elhep/SPEC_A7_Management/README.md

# SPEC_A7_Management
A plugin board for WR node management with ARM processor, SFP and RJ45
