elhep/SPEC_A7_Management/SPEC_A7_Management.html

Reporting Options

# File in Newer Format

Date | : | 27.06.2024
Time | : | 14:12:44
Project name | : | C:\Users\candle\Documents\polibuda\SPEC_A7_Management\SPEC_A7_Management.PrjPcb
Schematic documents | : | ETH_PHY_SFP.SchDoc , SPEC_A7_Power.SchDoc , SPEC_A7_SoM.SchDoc

Version | Warning
21.9.0 | Internal Pull Up/Down resistor in components are not supported in this version.
22.3.0 | Custom diff pair suffixes are not supported in this version.

These files were generated in a later version of Altium Designer. Be aware that some data may have been added through functionality not available in your current version and will therefore not be available to you.
