elhep/SPEC_A7_Management/SPEC_A7_Management.PCBDOC.htm

Reporting Options

# File in Newer Format

Date | : | 27.06.2024
Time | : | 14:24:59
Filename | : | C:\Users\candle\Documents\polibuda\SPEC_A7_Management\SPEC_A7_Management.PCBDOC

Version | Warning
Release 23.6 | CAUTION - The PCB document contains Footprint parameters. These will be lost when opening the document in a version of Altium Designer that does not support this functionality.

This file was generated by a later version of the software
