elhep/SPEC_A7_Management/SPEC_A7_Management.step

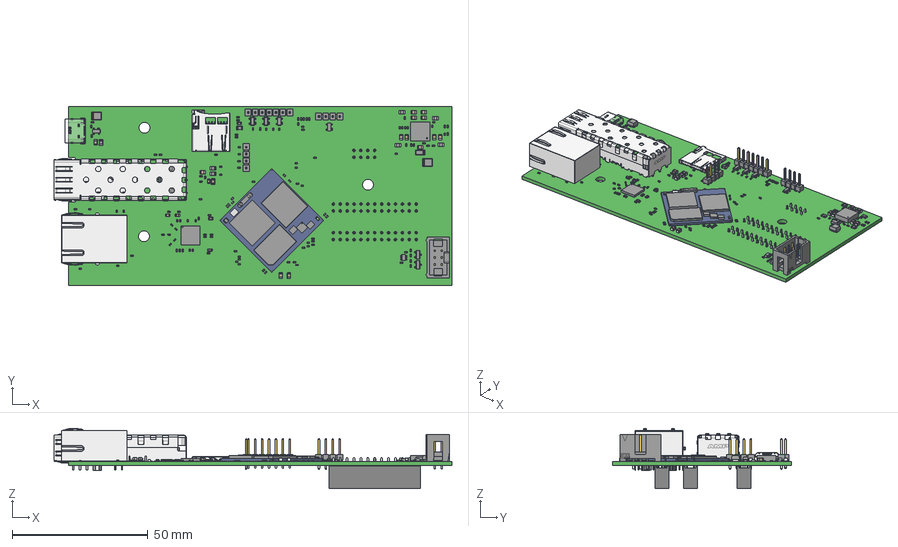
[picture p1: CAD file, 2024-09-16]
SPEC_A7_Management.step
146.4 x 65.8 x 22.2 mm
RESC1005X40N x 79
SOT65P210X110-6N
SOT95P248X115-3N x 2
INDC2012X110N x 4
ATTEND_112A-TAAR-R03
CAPC1005X55N x 39
CAPC1608X80N x 6
6130xx21821_PIN x 60
3M_N2506-6002RB
SOT143N x 5
SAMTEC_TSW-104-23-L-S x 2
RESC2012X60N x 4
SAMTEC_TSW-107-07-L-S-LL
USB4105-15-A_PART2
1_MIR
GCT
TYCO_1367073-1
BEL_L829-1J1T-43
MPS_MPM54304GMN
CAPC2012X135N x 14
CAPMP3528X210N x 2
KARO_QSMP-1530
QFN50P700X700X100-49N-S420
TYCO_6367035-1_(Cage Top)
TYCO_6367034-1_(Cage Bot)
