elhep/SPEC_A7_Management/(list of files, drawings)

Other design files:
ETH_PHY_SFP.SchDoc
SPEC_A7.SchDoc
SPEC_A7_Management.PCBDOC
SPEC_A7_Management.PcbLib
SPEC_A7_Management.PrjPcb
SPEC_A7_Management.SCHLIB
SPEC_A7_Managment-TOP.SchDoc
SPEC_A7_Power.SchDoc
SPEC_A7_SoM.SchDoc
