elhep/SPEC_A7_Management/(threads)

Thread 1 (2024-05-31):

Management board for SPEC-A7

gkasprow, 2024-05-31:
The management board has the following features:
- RJ45 Base10/100/1000 T Ethernet connector (DP83869HMRGZ); use low cost connector
- SFP 100/1000 Ethernet connector (same DP83869HMRGZ as above)
- automatic detection between SFP/RJ45, using SFP present signal (needs PHY reconfiguration)
- ARM SOM capable of running Linux and 2x RGMII Ethernet (QSMP); one RGMII goes to PHY, another goes to SPEC-A7; don't forget about series termination
- must fit together with SPEC-A7 into F1040-160 Bopla enclosure
- 4 layer PCB

Example configuration:
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

gkasprow, 2024-06-07:
The CPU is connected in following way:
- RGMII 1 routed to PHY which is shared between RJ45 and SFP
- RGMII 2 routed to WR node connector
- UART is routed to WR node connector
- CPU supply is derived from 12V rail on WR node connector

Thread 2 (2024-06-28):

design review

gkasprow, 2024-06-28:
SCH:
- [ ] add .gitignore
- [ ] add IDC connector with power supply status
- [ ] that thing won't work: the MCP has open drain, connect button to its output, VDD to 3V3 and passive network is not needed
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
- [ ] the power supply chip already generates PG signal that can be used to reset the SOM as in the original design
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
- [ ] such thing is hard to read, just route individual GPIOs without harnesses
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
- [ ] for the moment P1V1 wakes up first with 1V8, then 2V5 and 3V3. It violates the PHY sequence requirements
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

- [ ] connect SFP I2C to SoM. We need to report the optical power and configure SFP between SGMII/1000base-x mode
- [ ] use WUT schematic[ template](https://www.dropbox.com/scl/fi/se83k2msd5s09xg1agza3/WUT-template-A3.SchDot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) everywhere:
- [ ] add 33Ohm series termination resistors at the RGMII output lines that go to the FPGA
- [ ] add series 1k resistors between FPGA and SoM to prevent from latchup
- [ ] add 1A thermal fuse on USB port; during plug insertion the buck may restart and may cause to restart other channels.
- [ ] there are no strapping pins (PHY config) on schematic; is this done on purpose?
- [ ] pls add voltage detection circuit that will report loss of one of redundant supplies
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

- [ ] place the power unit status header somewhere here
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

gkasprow, 2024-06-28:
PCB:

- [ ] follow datasheet of SOM with vias tenting; copy the footprint from K700-178 design
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
- [ ] replace SOM and other libs with CERN symbols and footprints

gkasprow, 2024-06-28:
- [ ] use one of [supported OpenOCD jtag](https://openocd.org/pages/supported-jtag-interfaces.html) adapters, for the moment Xilinx JTAG connector is used; maybe switch to the pin header used on Ka-Ro boards
- [ ]
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

gkasprow, 2024-07-09:
there is conflict with enclosure
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
The 2.54 connectors are too high, the RJ45 will hit the wall
Use lower profile connectors, for the moment elevated ones are used with no reason

Thread 3 (2024-06-28):

for the moment P1V1 wakes up first with 1V8, then 2V5 and 3V3. It violates the PHY sequence requirements

gyorka, 2024-06-28:

gyorka, 2024-06-28:
actually, what the table says is that any of the supply voltages needs to ramp up in minimum of 0.5ms, but also that there is no sequence to be followed - any voltage can start within the period of 0 to 100ms and device will function as designed

Closed 2024-06-28.

Thread 4 (2024-07-02):

we need R20 and R22 to talk to SFP

gyorka, 2024-07-02:

gyorka, 2024-07-02:
without Ka-Ro QS93 SoM schematics it's uncertain if pull-up resistors are present on SDA/SCL lines or not, thus R20 and R22 are TBD, and currently marked as not populated

gkasprow, 2024-07-03:
the schematics are on my dropbox

Thread 5 (2024-07-02):

there are no strapping pins (PHY config) on schematic; is this done on purpose?

gyorka, 2024-07-02:

gyorka, 2024-07-02:
DP83869 default configuration, without any bootstraping resistors added is 1000Base-T using RGMII interface as required by the project
futher configuration can be adjusted with MDIO interface

Closed 2024-07-02.

Thread 6 (2024-07-02):

add 33Ohm series termination resistors at the RGMII output lines that go to the FPGA

gyorka, 2024-07-02:

gyorka, 2024-07-02:
at spec_a7 fpga_34.schdoc there are 33R resistors at RGMII TX lines, should we add 33R resistors at RX lines here? or its already good as it is?
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

gkasprow, 2024-07-03:
Oh, the resistor on SPEC side are on wrong lines, FPGA Tx means input; Add them on Tx lines on your side

gyorka, 2024-07-03:
so I should also connect TX to RX port and vice versa?

gkasprow, 2024-07-03:
No, follow Ethernet rules; Rx connects with Rx, Tx with Tx;
use source ermination on your output signals

gyorka, 2024-07-08:
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
done

Closed 2024-07-08.

Thread 7 (2024-07-02):

pls add voltage detection circuit that will report loss of one of redundant supplies ; do NOT connect P5V0 rail to this connector!

gyorka, 2024-07-02:

gyorka, 2024-07-02:
we have no redundant power supply - all we have is a single 12V source plus a single 3.3V source

what good would detection of 12V supply loss would do if our lights went off?

gkasprow, 2024-07-03:
We do have redundant power supply
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

gyorka, 2024-07-07:
as already stated: we don't have any redundant power supply within spec_a7_managment board - all we have is single 12V supply and single 3.3V supply

gkasprow, 2024-07-07:
Just implement it. We do have redundant power board with 2 IEC power entries.

gkasprow, 2024-07-07:
Its outside of this board but management board will send notification about loss of one of supplies using snmp.

Closed 2024-07-09.

Thread 8 (2024-07-04):

add SPI upgrade connector

gkasprow, 2024-07-04:
add yet another connector for FPGA SPI upgrade
connect FPGA DONE, INIT and UP EN to GPIOs

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

gyorka, 2024-07-08:
we need SAMTEC_ESQ-104-12-L-D for this, using "compatible" connector right now, CERN library needs to be updated

Closed 2024-07-08.

Thread 10 (2024-07-08):

USB port lacks 5V power; SOM does not generate 5V power! re-arrange the power supply chip and let the PHY generate one of the voltages internally

gyorka, 2024-07-08:

gyorka, 2024-07-08:
USB as is is configured for DEVICE mode of operation (5k1 resistors on CC pins), and 5V should be provided from the host
On SoM there is voltage divider on that pin to detect it.
USB port in this form is inteded to be used as SoM firmware update port, nothing else
for more convinient firmware development, SD card connector is provided, and we can use ethernet and scp for smaller files

gkasprow, 2024-07-09:
This is USB Host. Please add jumper that let the user to switch roles.
We need USB host to talk to FTDI on lower board to debug FPGA design remotely.

Closed 2024-07-08.

Thread 15 (2025-04-07):

missing I2C routing for SFP

ras14k, 2025-04-07:
signals on the schematic are connected in wrong order (SCL/SDA swapped):
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

missing routing:
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

Thread 18 (2025-04-07):

missing pull-up resistor on PWR_GOOD signal

ras14k, 2025-04-07:
without pull-up resistor SoM is permanently in reset

Thread 21 (2025-05-07):

jitter measurement

gkasprow, 2025-05-07:
free-running mode
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

Thread 22 (2025-07-10):

missing routing to JTAG on SPECA7

ras14k, 2025-07-10:
One of the features provided by management board is XVC (Xilinx Virtual Cable), but right now there is no direct connections between SoM's GPIOs and JTAG on SPECA7.

Solution 1: connect signals to unused pins on header J1, but it requires changes on SPECA7 board.
Solution 2 (probably better idea): add another header on management board and connect with existing JTAG header on SPECA7 (J6) using ribbon cable.
