elhep/SPEC_A7_Management/(commit log)

2024-06-25 initial release
    [ETH_PHY_SFP.SchDoc, SPEC_A7.SchDoc, SPEC_A7_Management.PcbLib, SPEC_A7_Management.PrjPcb, SPEC_A7_Management.SCHLIB, SPEC_A7_Managment-TOP.SchDoc, SPEC_A7_Power.SchDoc, SPEC_A7_SoM.SchDoc]
2024-06-28 Initial commit, todo: align eth2 rgmii interface
    [SPEC_A7_Management.PcbLib]
2024-07-08 functional update: added all of requested features/resolved all reported issues
    [ETH_PHY_SFP.SchDoc, SPEC_A7.SchDoc, SPEC_A7_Management.PrjPcb, SPEC_A7_Managment-TOP.SchDoc, SPEC_A7_Power.SchDoc, SPEC_A7_SoM.SchDoc]
2024-09-16 changed samtec headers for J1, J2 & J8 to wurth equivalents - now stackup height should be 11mm (board to board)
    [SPEC_A7.SchDoc, SPEC_A7_Management.PCBDOC, SPEC_A7_Management.PrjPcb, SPEC_A7_Management.step]
